wgbowley/BlueFin-LSM/sim_and_opt/readme.md

## Uses femm through pyfemm & blueshark framework:
- Simulate Designs
- Optimize Designs

Go to https://github.com/wgbowley/BlueShark, download and run: ```pip install blueshark```

<b>Note:</b> 
Relative performance is the key metric and absolute performance should be taken with scepticism
