wgbowley/BlueFin-LSM/(commit log)

2025-08-05 Inital Commit
    Saving files
    [motor.yaml]
2025-08-12 Quick Save of fixed axial pole length
    [motor.yaml]
2025-08-30 All of random files
    - Alot of data files
    - Coil Winder code
    - Weighted best program
    - Iron back linear motor
    [single_fed_motor_first_run_9coils.json, single_fed_motor_second_run_3coils.json]
2025-09-16 Setting up project
    The start of big things :)
    [single_fed_motor_first_run_9coils.json, single_fed_motor_second_run_3coils.json]
2025-09-20 Added prototype V0 model and also application notes
    - Added prototype V0 from fusion 360 as a .iges
    - Added application notes from prototype V0
    - Fixed spelling and grammar in readme.
